pabstaaron/AutoCoffeeMaker/proposal/SeniorProjectProposal/brewStretch.png

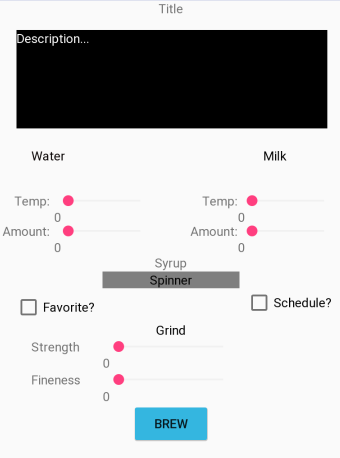
proposal/SeniorProjectProposal/brewStretch.png
