pabstaaron/AutoCoffeeMaker/proposal/SeniorProjectProposal/connect.png

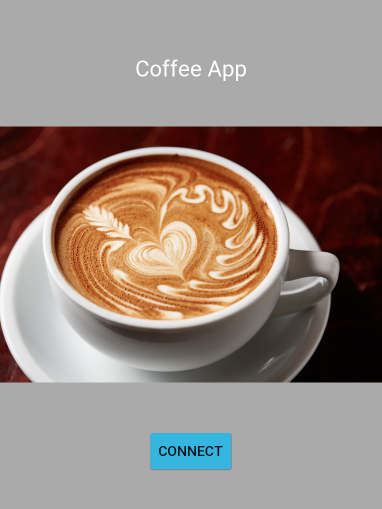
proposal/SeniorProjectProposal/connect.png
