pabstaaron/AutoCoffeeMaker/proposal/SeniorProjectProposal/IMG_20181216_222614.jpg

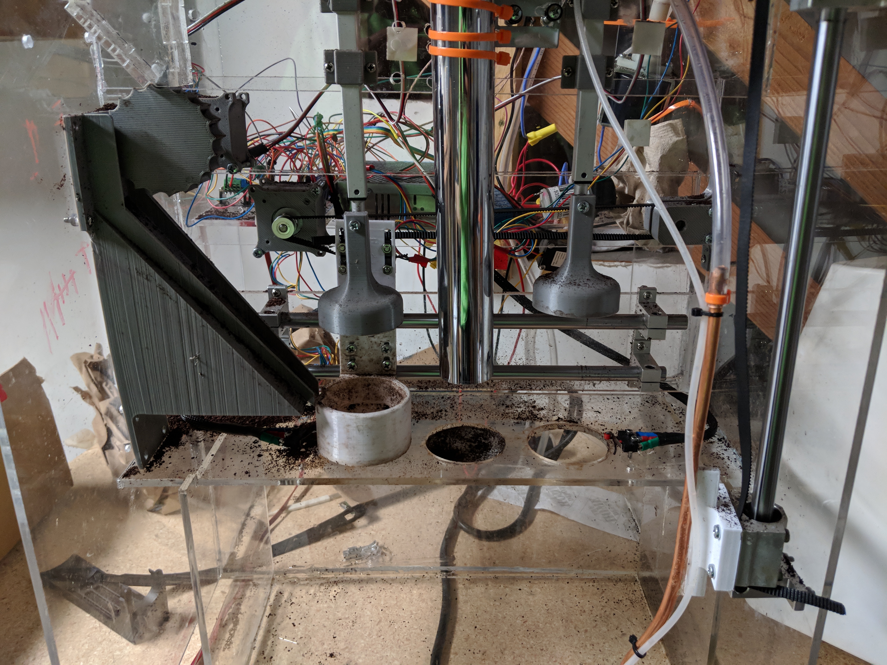
proposal/SeniorProjectProposal/IMG_20181216_222614.jpg
