pabstaaron/AutoCoffeeMaker/proposal/SeniorProjectProposal/Load.png

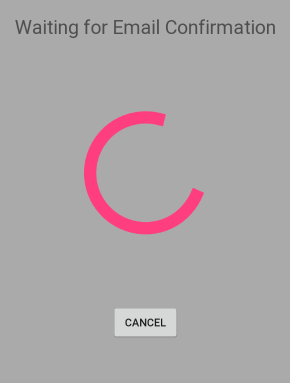
proposal/SeniorProjectProposal/Load.png
