pabstaaron/AutoCoffeeMaker/proposal/SeniorProjectProposal/loginStretch.png

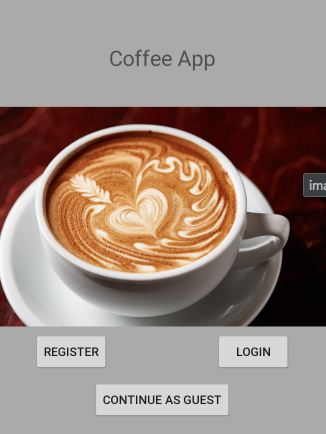
proposal/SeniorProjectProposal/loginStretch.png
