pabstaaron/AutoCoffeeMaker/proposal/SeniorProjectProposal/menu.png

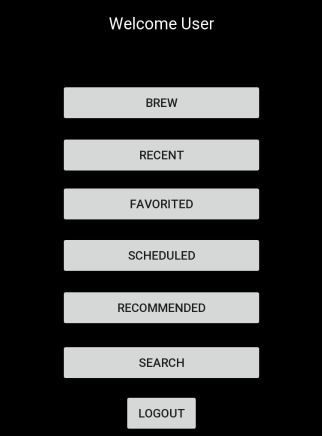
proposal/SeniorProjectProposal/menu.png
