pabstaaron/AutoCoffeeMaker/proposal/SeniorProjectProposal/original pcb layout.png

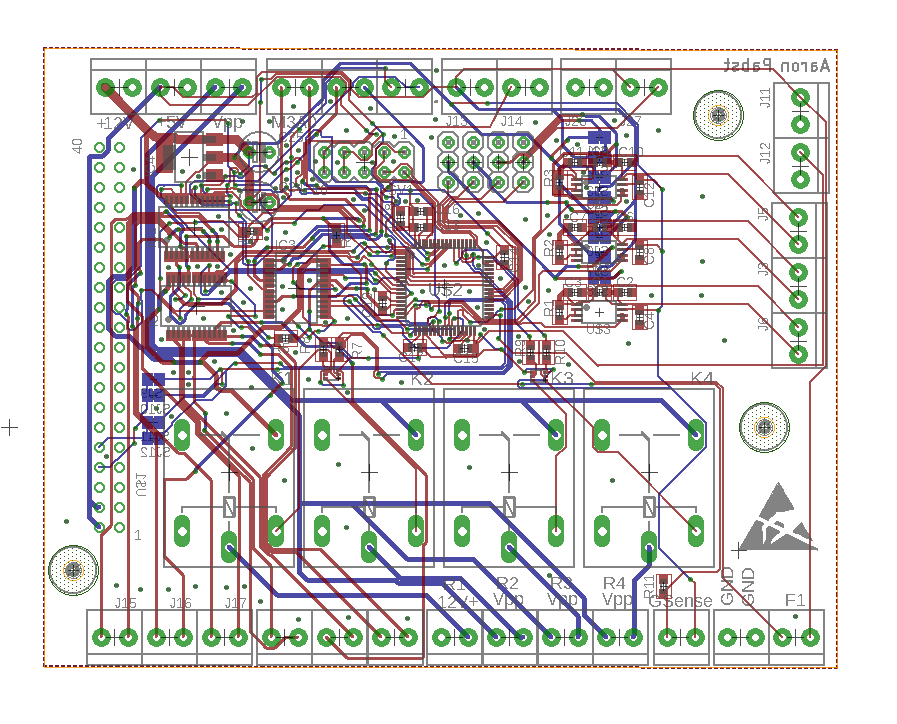
proposal/SeniorProjectProposal/original pcb layout.png
