pabstaaron/AutoCoffeeMaker/proposal/SeniorProjectProposal/original schematic pg 1.png

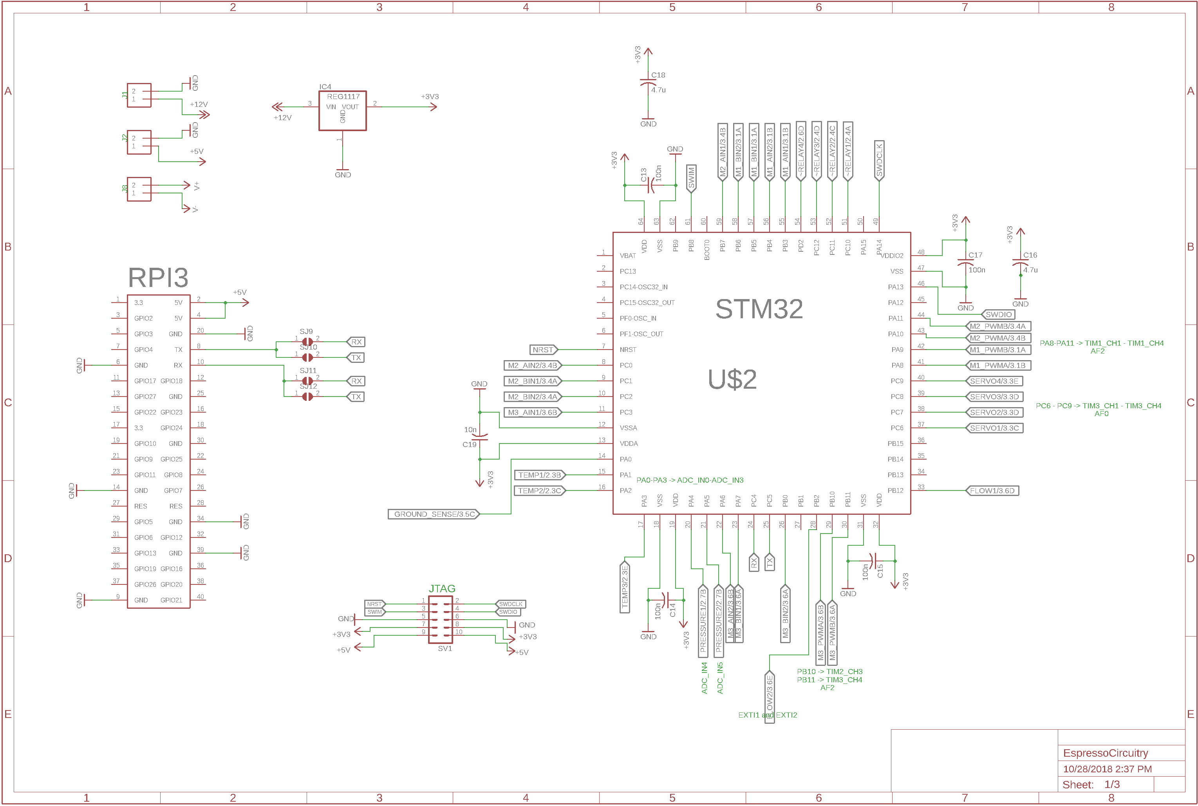
proposal/SeniorProjectProposal/original schematic pg 1.png
