pabstaaron/AutoCoffeeMaker/proposal/SeniorProjectProposal/original schematic pg 2.png

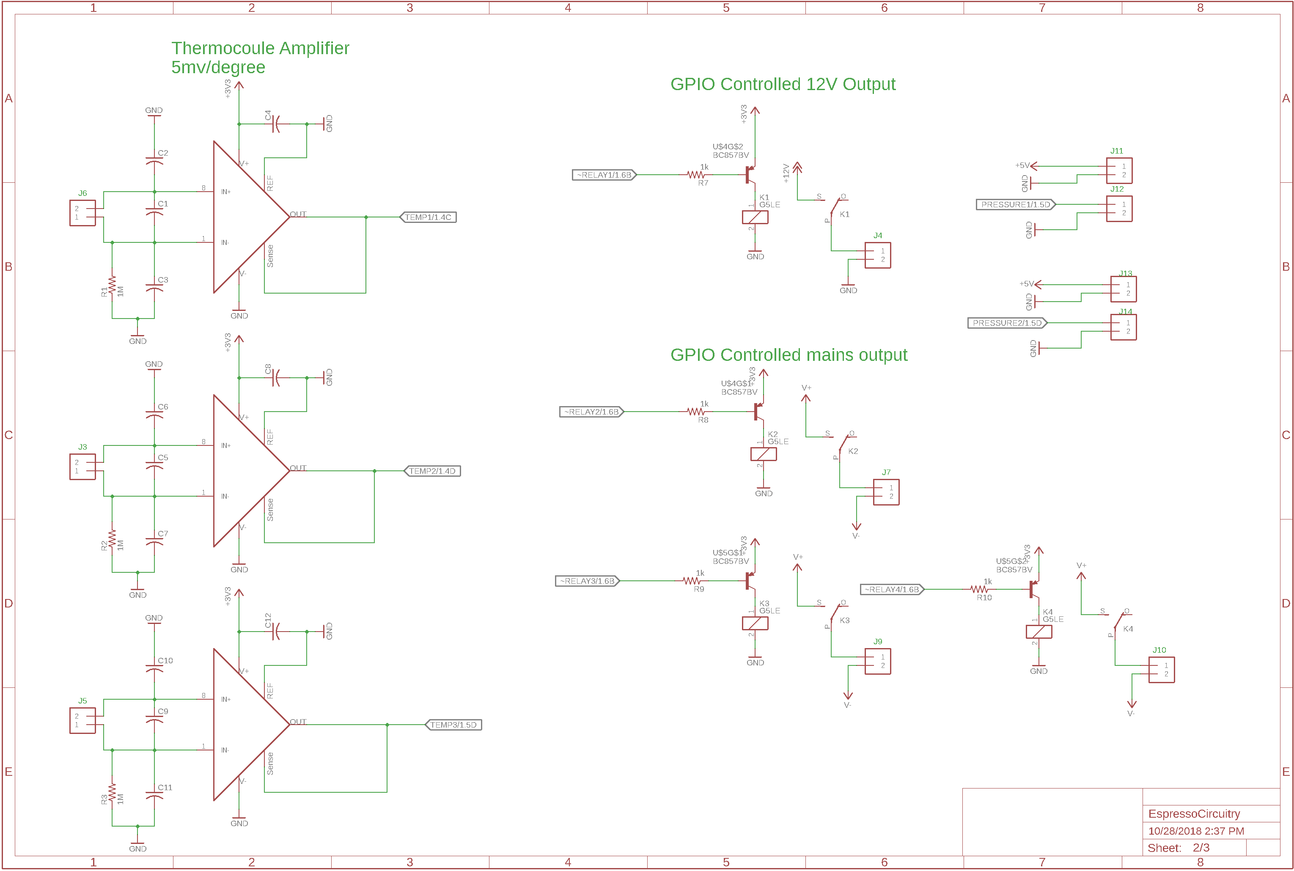
proposal/SeniorProjectProposal/original schematic pg 2.png
