pabstaaron/AutoCoffeeMaker/proposal/SeniorProjectProposal/original schematic pg 3.png

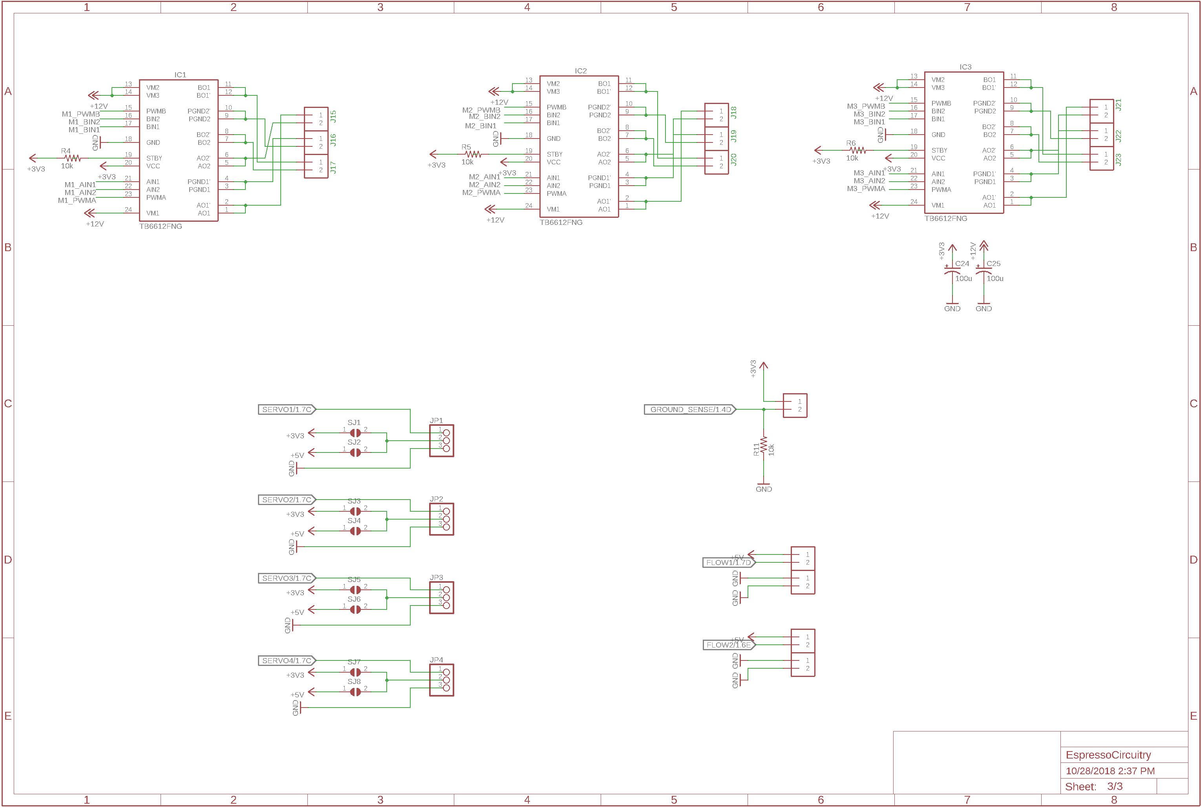
proposal/SeniorProjectProposal/original schematic pg 3.png
