pabstaaron/AutoCoffeeMaker/proposal/SeniorProjectProposal/Register.png

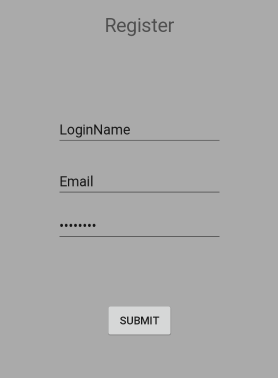
proposal/SeniorProjectProposal/Register.png
