pabstaaron/AutoCoffeeMaker/proposal/SeniorProjectProposal/Schedule.png

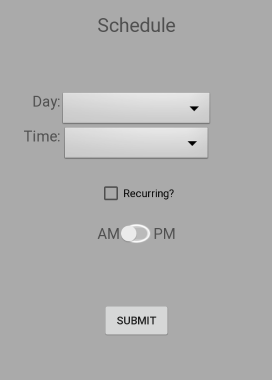
proposal/SeniorProjectProposal/Schedule.png
