pabstaaron/AutoCoffeeMaker/proposal/SeniorProjectProposal/Scheduled.png

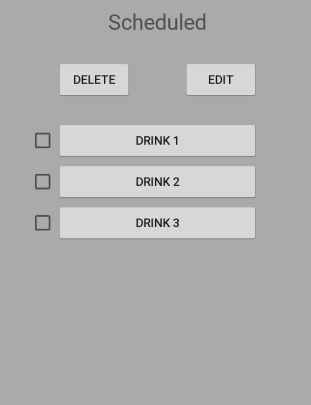
proposal/SeniorProjectProposal/Scheduled.png
