pabstaaron/AutoCoffeeMaker/proposal/SeniorProjectProposal/Search.png

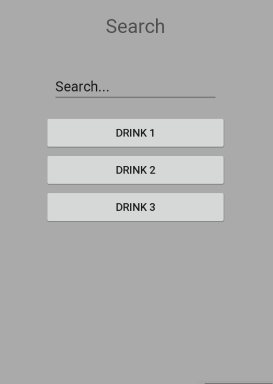
proposal/SeniorProjectProposal/Search.png
