pabstaaron/AutoCoffeeMaker/proposal/SeniorProjectProposal/wifi.png

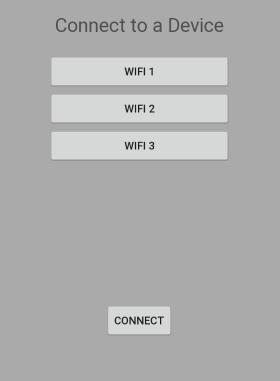
proposal/SeniorProjectProposal/wifi.png
