pabstaaron/AutoCoffeeMaker/EmbeddedCode/gpioTest/MDK-ARM/gpioTest/gpioTest.htm

# Static Call Graph for image gpioTest\gpioTest.axf

#<CALLGRAPH># ARM Linker, 5060750: Last Updated: Tue Oct 30 19:10:04 2018

### Maximum Stack Usage = 188 bytes + Unknown(Cycles, Untraceable Function Pointers)

### Call chain for Maximum Stack Depth:

main ⇒ SystemClock_Config ⇒ HAL_RCC_ClockConfig ⇒ HAL_RCC_GetSysClockFreq ⇒ __aeabi_uidivmod

### Mutually Recursive functions

- ADC1_COMP_IRQHandler ⇒ ADC1_COMP_IRQHandler
- HardFault_Handler ⇒ HardFault_Handler

### Function Pointers

- ADC1_COMP_IRQHandler from startup_stm32f072xb.o(.text) referenced from startup_stm32f072xb.o(RESET)
- CEC_CAN_IRQHandler from startup_stm32f072xb.o(.text) referenced from startup_stm32f072xb.o(RESET)
- DMA1_Channel1_IRQHandler from startup_stm32f072xb.o(.text) referenced from startup_stm32f072xb.o(RESET)
- DMA1_Channel2_3_IRQHandler from startup_stm32f072xb.o(.text) referenced from startup_stm32f072xb.o(RESET)
- DMA1_Channel4_5_6_7_IRQHandler from startup_stm32f072xb.o(.text) referenced from startup_stm32f072xb.o(RESET)
- EXTI0_1_IRQHandler from startup_stm32f072xb.o(.text) referenced from startup_stm32f072xb.o(RESET)
- EXTI2_3_IRQHandler from startup_stm32f072xb.o(.text) referenced from startup_stm32f072xb.o(RESET)
- EXTI4_15_IRQHandler from startup_stm32f072xb.o(.text) referenced from startup_stm32f072xb.o(RESET)
- FLASH_IRQHandler from startup_stm32f072xb.o(.text) referenced from startup_stm32f072xb.o(RESET)
- HardFault_Handler from stm32f0xx_it.o(i.HardFault_Handler) referenced from startup_stm32f072xb.o(RESET)
- I2C1_IRQHandler from startup_stm32f072xb.o(.text) referenced from startup_stm32f072xb.o(RESET)
- I2C2_IRQHandler from startup_stm32f072xb.o(.text) referenced from startup_stm32f072xb.o(RESET)
- NMI_Handler from stm32f0xx_it.o(i.NMI_Handler) referenced from startup_stm32f072xb.o(RESET)
- PVD_VDDIO2_IRQHandler from startup_stm32f072xb.o(.text) referenced from startup_stm32f072xb.o(RESET)
- PendSV_Handler from stm32f0xx_it.o(i.PendSV_Handler) referenced from startup_stm32f072xb.o(RESET)
- RCC_CRS_IRQHandler from startup_stm32f072xb.o(.text) referenced from startup_stm32f072xb.o(RESET)
- RTC_IRQHandler from startup_stm32f072xb.o(.text) referenced from startup_stm32f072xb.o(RESET)
- Reset_Handler from startup_stm32f072xb.o(.text) referenced from startup_stm32f072xb.o(RESET)
- SPI1_IRQHandler from startup_stm32f072xb.o(.text) referenced from startup_stm32f072xb.o(RESET)
- SPI2_IRQHandler from startup_stm32f072xb.o(.text) referenced from startup_stm32f072xb.o(RESET)
- SVC_Handler from stm32f0xx_it.o(i.SVC_Handler) referenced from startup_stm32f072xb.o(RESET)
- SysTick_Handler from stm32f0xx_it.o(i.SysTick_Handler) referenced from startup_stm32f072xb.o(RESET)
- SystemInit from system_stm32f0xx.o(i.SystemInit) referenced from startup_stm32f072xb.o(.text)
- TIM14_IRQHandler from startup_stm32f072xb.o(.text) referenced from startup_stm32f072xb.o(RESET)
- TIM15_IRQHandler from startup_stm32f072xb.o(.text) referenced from startup_stm32f072xb.o(RESET)
- TIM16_IRQHandler from startup_stm32f072xb.o(.text) referenced from startup_stm32f072xb.o(RESET)
- TIM17_IRQHandler from startup_stm32f072xb.o(.text) referenced from startup_stm32f072xb.o(RESET)
- TIM1_BRK_UP_TRG_COM_IRQHandler from startup_stm32f072xb.o(.text) referenced from startup_stm32f072xb.o(RESET)
- TIM1_CC_IRQHandler from startup_stm32f072xb.o(.text) referenced from startup_stm32f072xb.o(RESET)
- TIM2_IRQHandler from startup_stm32f072xb.o(.text) referenced from startup_stm32f072xb.o(RESET)
- TIM3_IRQHandler from startup_stm32f072xb.o(.text) referenced from startup_stm32f072xb.o(RESET)
- TIM6_DAC_IRQHandler from startup_stm32f072xb.o(.text) referenced from startup_stm32f072xb.o(RESET)
- TIM7_IRQHandler from startup_stm32f072xb.o(.text) referenced from startup_stm32f072xb.o(RESET)
- TSC_IRQHandler from startup_stm32f072xb.o(.text) referenced from startup_stm32f072xb.o(RESET)
- USART1_IRQHandler from startup_stm32f072xb.o(.text) referenced from startup_stm32f072xb.o(RESET)
- USART2_IRQHandler from startup_stm32f072xb.o(.text) referenced from startup_stm32f072xb.o(RESET)
- USART3_4_IRQHandler from startup_stm32f072xb.o(.text) referenced from startup_stm32f072xb.o(RESET)
- USB_IRQHandler from startup_stm32f072xb.o(.text) referenced from startup_stm32f072xb.o(RESET)
- WWDG_IRQHandler from startup_stm32f072xb.o(.text) referenced from startup_stm32f072xb.o(RESET)
- __main from entry.o(.ARM.Collect$$$$00000000) referenced from startup_stm32f072xb.o(.text)
- main from main.o(i.main) referenced from entry9a.o(.ARM.Collect$$$$0000000B)

### Global Symbols

__main (Thumb, 0 bytes, Stack size unknown bytes, entry.o(.ARM.Collect$$$$00000000))
[Address Reference Count : 1]

- startup_stm32f072xb.o(.text)

_main_stk (Thumb, 0 bytes, Stack size unknown bytes, entry2.o(.ARM.Collect$$$$00000001))

_main_scatterload (Thumb, 0 bytes, Stack size unknown bytes, entry5.o(.ARM.Collect$$$$00000004))

[Calls]

- >> __scatterload

__main_after_scatterload (Thumb, 0 bytes, Stack size unknown bytes, entry5.o(.ARM.Collect$$$$00000004))

[Called By]

- >> __scatterload

_main_clock (Thumb, 0 bytes, Stack size unknown bytes, entry7b.o(.ARM.Collect$$$$00000008))

_main_cpp_init (Thumb, 0 bytes, Stack size unknown bytes, entry8b.o(.ARM.Collect$$$$0000000A))

_main_init (Thumb, 0 bytes, Stack size unknown bytes, entry9a.o(.ARM.Collect$$$$0000000B))

__rt_final_cpp (Thumb, 0 bytes, Stack size unknown bytes, entry10a.o(.ARM.Collect$$$$0000000D))

__rt_final_exit (Thumb, 0 bytes, Stack size unknown bytes, entry11a.o(.ARM.Collect$$$$0000000F))

Reset_Handler (Thumb, 8 bytes, Stack size 0 bytes, startup_stm32f072xb.o(.text))
[Address Reference Count : 1]

- startup_stm32f072xb.o(RESET)

ADC1_COMP_IRQHandler (Thumb, 0 bytes, Stack size 0 bytes, startup_stm32f072xb.o(.text))

[Calls]

- >> ADC1_COMP_IRQHandler

[Called By]

- >> ADC1_COMP_IRQHandler

[Address Reference Count : 1]

- startup_stm32f072xb.o(RESET)

CEC_CAN_IRQHandler (Thumb, 0 bytes, Stack size 0 bytes, startup_stm32f072xb.o(.text))
[Address Reference Count : 1]

- startup_stm32f072xb.o(RESET)

DMA1_Channel1_IRQHandler (Thumb, 0 bytes, Stack size 0 bytes, startup_stm32f072xb.o(.text))
[Address Reference Count : 1]

- startup_stm32f072xb.o(RESET)

DMA1_Channel2_3_IRQHandler (Thumb, 0 bytes, Stack size 0 bytes, startup_stm32f072xb.o(.text))
[Address Reference Count : 1]

- startup_stm32f072xb.o(RESET)

DMA1_Channel4_5_6_7_IRQHandler (Thumb, 0 bytes, Stack size 0 bytes, startup_stm32f072xb.o(.text))
[Address Reference Count : 1]

- startup_stm32f072xb.o(RESET)

EXTI0_1_IRQHandler (Thumb, 0 bytes, Stack size 0 bytes, startup_stm32f072xb.o(.text))
[Address Reference Count : 1]

- startup_stm32f072xb.o(RESET)

EXTI2_3_IRQHandler (Thumb, 0 bytes, Stack size 0 bytes, startup_stm32f072xb.o(.text))
[Address Reference Count : 1]

- startup_stm32f072xb.o(RESET)

EXTI4_15_IRQHandler (Thumb, 0 bytes, Stack size 0 bytes, startup_stm32f072xb.o(.text))
[Address Reference Count : 1]

- startup_stm32f072xb.o(RESET)

FLASH_IRQHandler (Thumb, 0 bytes, Stack size 0 bytes, startup_stm32f072xb.o(.text))
[Address Reference Count : 1]

- startup_stm32f072xb.o(RESET)

I2C1_IRQHandler (Thumb, 0 bytes, Stack size 0 bytes, startup_stm32f072xb.o(.text))
[Address Reference Count : 1]

- startup_stm32f072xb.o(RESET)

I2C2_IRQHandler (Thumb, 0 bytes, Stack size 0 bytes, startup_stm32f072xb.o(.text))
[Address Reference Count : 1]

- startup_stm32f072xb.o(RESET)

PVD_VDDIO2_IRQHandler (Thumb, 0 bytes, Stack size 0 bytes, startup_stm32f072xb.o(.text))
[Address Reference Count : 1]

- startup_stm32f072xb.o(RESET)

RCC_CRS_IRQHandler (Thumb, 0 bytes, Stack size 0 bytes, startup_stm32f072xb.o(.text))
[Address Reference Count : 1]

- startup_stm32f072xb.o(RESET)

RTC_IRQHandler (Thumb, 0 bytes, Stack size 0 bytes, startup_stm32f072xb.o(.text))
[Address Reference Count : 1]

- startup_stm32f072xb.o(RESET)

SPI1_IRQHandler (Thumb, 0 bytes, Stack size 0 bytes, startup_stm32f072xb.o(.text))
[Address Reference Count : 1]

- startup_stm32f072xb.o(RESET)

SPI2_IRQHandler (Thumb, 0 bytes, Stack size 0 bytes, startup_stm32f072xb.o(.text))
[Address Reference Count : 1]

- startup_stm32f072xb.o(RESET)

TIM14_IRQHandler (Thumb, 0 bytes, Stack size 0 bytes, startup_stm32f072xb.o(.text))
[Address Reference Count : 1]

- startup_stm32f072xb.o(RESET)

TIM15_IRQHandler (Thumb, 0 bytes, Stack size 0 bytes, startup_stm32f072xb.o(.text))
[Address Reference Count : 1]

- startup_stm32f072xb.o(RESET)

TIM16_IRQHandler (Thumb, 0 bytes, Stack size 0 bytes, startup_stm32f072xb.o(.text))
[Address Reference Count : 1]

- startup_stm32f072xb.o(RESET)

TIM17_IRQHandler (Thumb, 0 bytes, Stack size 0 bytes, startup_stm32f072xb.o(.text))
[Address Reference Count : 1]

- startup_stm32f072xb.o(RESET)

TIM1_BRK_UP_TRG_COM_IRQHandler (Thumb, 0 bytes, Stack size 0 bytes, startup_stm32f072xb.o(.text))
[Address Reference Count : 1]

- startup_stm32f072xb.o(RESET)

TIM1_CC_IRQHandler (Thumb, 0 bytes, Stack size 0 bytes, startup_stm32f072xb.o(.text))
[Address Reference Count : 1]

- startup_stm32f072xb.o(RESET)

TIM2_IRQHandler (Thumb, 0 bytes, Stack size 0 bytes, startup_stm32f072xb.o(.text))
[Address Reference Count : 1]

- startup_stm32f072xb.o(RESET)

TIM3_IRQHandler (Thumb, 0 bytes, Stack size 0 bytes, startup_stm32f072xb.o(.text))
[Address Reference Count : 1]

- startup_stm32f072xb.o(RESET)

TIM6_DAC_IRQHandler (Thumb, 0 bytes, Stack size 0 bytes, startup_stm32f072xb.o(.text))
[Address Reference Count : 1]

- startup_stm32f072xb.o(RESET)

TIM7_IRQHandler (Thumb, 0 bytes, Stack size 0 bytes, startup_stm32f072xb.o(.text))
[Address Reference Count : 1]

- startup_stm32f072xb.o(RESET)

TSC_IRQHandler (Thumb, 0 bytes, Stack size 0 bytes, startup_stm32f072xb.o(.text))
[Address Reference Count : 1]

- startup_stm32f072xb.o(RESET)

USART1_IRQHandler (Thumb, 0 bytes, Stack size 0 bytes, startup_stm32f072xb.o(.text))
[Address Reference Count : 1]

- startup_stm32f072xb.o(RESET)

USART2_IRQHandler (Thumb, 0 bytes, Stack size 0 bytes, startup_stm32f072xb.o(.text))
[Address Reference Count : 1]

- startup_stm32f072xb.o(RESET)

USART3_4_IRQHandler (Thumb, 0 bytes, Stack size 0 bytes, startup_stm32f072xb.o(.text))
[Address Reference Count : 1]

- startup_stm32f072xb.o(RESET)

USB_IRQHandler (Thumb, 0 bytes, Stack size 0 bytes, startup_stm32f072xb.o(.text))
[Address Reference Count : 1]

- startup_stm32f072xb.o(RESET)

WWDG_IRQHandler (Thumb, 0 bytes, Stack size 0 bytes, startup_stm32f072xb.o(.text))
[Address Reference Count : 1]

- startup_stm32f072xb.o(RESET)

__aeabi_uidiv (Thumb, 0 bytes, Stack size 12 bytes, uidiv.o(.text), UNUSED)

__aeabi_uidivmod (Thumb, 44 bytes, Stack size 12 bytes, uidiv.o(.text))

[Stack]

- Max Depth = 12
- Call Chain = __aeabi_uidivmod

[Called By]

- >> HAL_InitTick
- >> HAL_RCC_GetSysClockFreq
- >> SystemClock_Config

__scatterload (Thumb, 28 bytes, Stack size 0 bytes, init.o(.text))

[Calls]

- >> __main_after_scatterload

[Called By]

- >> _main_scatterload

__scatterload_rt2 (Thumb, 0 bytes, Stack size 0 bytes, init.o(.text), UNUSED)

HAL_GPIO_Init (Thumb, 314 bytes, Stack size 24 bytes, stm32f0xx_hal_gpio.o(i.HAL_GPIO_Init))

[Stack]

- Max Depth = 24
- Call Chain = HAL_GPIO_Init

[Called By]

- >> main

HAL_GPIO_WritePin (Thumb, 12 bytes, Stack size 0 bytes, stm32f0xx_hal_gpio.o(i.HAL_GPIO_WritePin))

[Called By]

- >> main

HAL_GetTick (Thumb, 6 bytes, Stack size 0 bytes, stm32f0xx_hal.o(i.HAL_GetTick))

[Called By]

- >> HAL_RCC_OscConfig
- >> HAL_RCC_ClockConfig

HAL_IncTick (Thumb, 10 bytes, Stack size 0 bytes, stm32f0xx_hal.o(i.HAL_IncTick))

[Called By]

- >> SysTick_Handler

HAL_Init (Thumb, 26 bytes, Stack size 8 bytes, stm32f0xx_hal.o(i.HAL_Init))

[Stack]

- Max Depth = 28
- Call Chain = HAL_Init ⇒ HAL_InitTick ⇒ __aeabi_uidivmod

[Calls]

- >> HAL_InitTick
- >> HAL_MspInit

[Called By]

- >> main

HAL_InitTick (Thumb, 34 bytes, Stack size 8 bytes, stm32f0xx_hal.o(i.HAL_InitTick))

[Stack]

- Max Depth = 20
- Call Chain = HAL_InitTick ⇒ __aeabi_uidivmod

[Calls]

- >> HAL_SYSTICK_Config
- >> HAL_RCC_GetHCLKFreq
- >> HAL_NVIC_SetPriority
- >> __aeabi_uidivmod

[Called By]

- >> HAL_RCC_ClockConfig
- >> HAL_Init

HAL_MspInit (Thumb, 64 bytes, Stack size 8 bytes, stm32f0xx_hal_msp.o(i.HAL_MspInit))

[Stack]

- Max Depth = 16
- Call Chain = HAL_MspInit ⇒ HAL_NVIC_SetPriority

[Calls]

- >> HAL_NVIC_SetPriority

[Called By]

- >> HAL_Init

HAL_NVIC_SetPriority (Thumb, 8 bytes, Stack size 8 bytes, stm32f0xx_hal_cortex.o(i.HAL_NVIC_SetPriority))

[Stack]

- Max Depth = 8
- Call Chain = HAL_NVIC_SetPriority

[Calls]

- >> NVIC_SetPriority

[Called By]

- >> HAL_InitTick
- >> HAL_MspInit
- >> SystemClock_Config

HAL_RCC_ClockConfig (Thumb, 320 bytes, Stack size 24 bytes, stm32f0xx_hal_rcc.o(i.HAL_RCC_ClockConfig))

[Stack]

- Max Depth = 84
- Call Chain = HAL_RCC_ClockConfig ⇒ HAL_RCC_GetSysClockFreq ⇒ __aeabi_uidivmod

[Calls]

- >> HAL_InitTick
- >> HAL_GetTick
- >> HAL_RCC_GetSysClockFreq

[Called By]

- >> SystemClock_Config

HAL_RCC_GetHCLKFreq (Thumb, 6 bytes, Stack size 0 bytes, stm32f0xx_hal_rcc.o(i.HAL_RCC_GetHCLKFreq))

[Called By]

- >> HAL_InitTick
- >> SystemClock_Config

HAL_RCC_GetSysClockFreq (Thumb, 90 bytes, Stack size 48 bytes, stm32f0xx_hal_rcc.o(i.HAL_RCC_GetSysClockFreq))

[Stack]

- Max Depth = 60
- Call Chain = HAL_RCC_GetSysClockFreq ⇒ __aeabi_uidivmod

[Calls]

- >> __aeabi_uidivmod

[Called By]

- >> HAL_RCC_ClockConfig

HAL_RCC_OscConfig (Thumb, 966 bytes, Stack size 32 bytes, stm32f0xx_hal_rcc.o(i.HAL_RCC_OscConfig))

[Stack]

- Max Depth = 32
- Call Chain = HAL_RCC_OscConfig

[Calls]

- >> HAL_GetTick

[Called By]

- >> SystemClock_Config

HAL_SYSTICK_CLKSourceConfig (Thumb, 20 bytes, Stack size 0 bytes, stm32f0xx_hal_cortex.o(i.HAL_SYSTICK_CLKSourceConfig))

[Called By]

- >> SystemClock_Config

HAL_SYSTICK_Callback (Thumb, 2 bytes, Stack size 0 bytes, stm32f0xx_hal_cortex.o(i.HAL_SYSTICK_Callback))

[Called By]

- >> HAL_SYSTICK_IRQHandler

HAL_SYSTICK_Config (Thumb, 38 bytes, Stack size 8 bytes, stm32f0xx_hal_cortex.o(i.HAL_SYSTICK_Config))

[Stack]

- Max Depth = 8
- Call Chain = HAL_SYSTICK_Config

[Calls]

- >> NVIC_SetPriority

[Called By]

- >> HAL_InitTick
- >> SystemClock_Config

HAL_SYSTICK_IRQHandler (Thumb, 8 bytes, Stack size 8 bytes, stm32f0xx_hal_cortex.o(i.HAL_SYSTICK_IRQHandler))

[Stack]

- Max Depth = 8
- Call Chain = HAL_SYSTICK_IRQHandler

[Calls]

- >> HAL_SYSTICK_Callback

[Called By]

- >> SysTick_Handler

HardFault_Handler (Thumb, 2 bytes, Stack size 0 bytes, stm32f0xx_it.o(i.HardFault_Handler))

[Calls]

- >> HardFault_Handler

[Called By]

- >> HardFault_Handler

[Address Reference Count : 1]

- startup_stm32f072xb.o(RESET)

NMI_Handler (Thumb, 2 bytes, Stack size 0 bytes, stm32f0xx_it.o(i.NMI_Handler))
[Address Reference Count : 1]

- startup_stm32f072xb.o(RESET)

PendSV_Handler (Thumb, 2 bytes, Stack size 0 bytes, stm32f0xx_it.o(i.PendSV_Handler))
[Address Reference Count : 1]

- startup_stm32f072xb.o(RESET)

SVC_Handler (Thumb, 2 bytes, Stack size 0 bytes, stm32f0xx_it.o(i.SVC_Handler))
[Address Reference Count : 1]

- startup_stm32f072xb.o(RESET)

SysTick_Handler (Thumb, 12 bytes, Stack size 8 bytes, stm32f0xx_it.o(i.SysTick_Handler))

[Stack]

- Max Depth = 16
- Call Chain = SysTick_Handler ⇒ HAL_SYSTICK_IRQHandler

[Calls]

- >> HAL_SYSTICK_IRQHandler
- >> HAL_IncTick

[Address Reference Count : 1]

- startup_stm32f072xb.o(RESET)

SystemClock_Config (Thumb, 92 bytes, Stack size 80 bytes, main.o(i.SystemClock_Config))

[Stack]

- Max Depth = 164
- Call Chain = SystemClock_Config ⇒ HAL_RCC_ClockConfig ⇒ HAL_RCC_GetSysClockFreq ⇒ __aeabi_uidivmod

[Calls]

- >> HAL_SYSTICK_Config
- >> HAL_SYSTICK_CLKSourceConfig
- >> HAL_RCC_OscConfig
- >> HAL_RCC_GetHCLKFreq
- >> HAL_RCC_ClockConfig
- >> HAL_NVIC_SetPriority
- >> __aeabi_uidivmod

[Called By]

- >> main

SystemInit (Thumb, 76 bytes, Stack size 0 bytes, system_stm32f0xx.o(i.SystemInit))
[Address Reference Count : 1]

- startup_stm32f072xb.o(.text)

__scatterload_copy (Thumb, 14 bytes, Stack size unknown bytes, handlers.o(i.__scatterload_copy), UNUSED)

__scatterload_null (Thumb, 2 bytes, Stack size unknown bytes, handlers.o(i.__scatterload_null), UNUSED)

__scatterload_zeroinit (Thumb, 14 bytes, Stack size unknown bytes, handlers.o(i.__scatterload_zeroinit), UNUSED)

main (Thumb, 74 bytes, Stack size 24 bytes, main.o(i.main))

[Stack]

- Max Depth = 188
- Call Chain = main ⇒ SystemClock_Config ⇒ HAL_RCC_ClockConfig ⇒ HAL_RCC_GetSysClockFreq ⇒ __aeabi_uidivmod

[Calls]

- >> HAL_Init
- >> HAL_GPIO_WritePin
- >> HAL_GPIO_Init
- >> SystemClock_Config

[Address Reference Count : 1]

- entry9a.o(.ARM.Collect$$$$0000000B)

### Local Symbols

NVIC_SetPriority (Thumb, 60 bytes, Stack size 0 bytes, stm32f0xx_hal_cortex.o(i.NVIC_SetPriority))

[Called By]

- >> HAL_SYSTICK_Config
- >> HAL_NVIC_SetPriority

### Undefined Global Symbols
