pabstaaron/AutoCoffeeMaker/Electronics/EspressoCircuitry/EspressoCircuitry.brd

## EAGLE design Electronics/EspressoCircuitry/EspressoCircuitry.brd (2018-10-07)

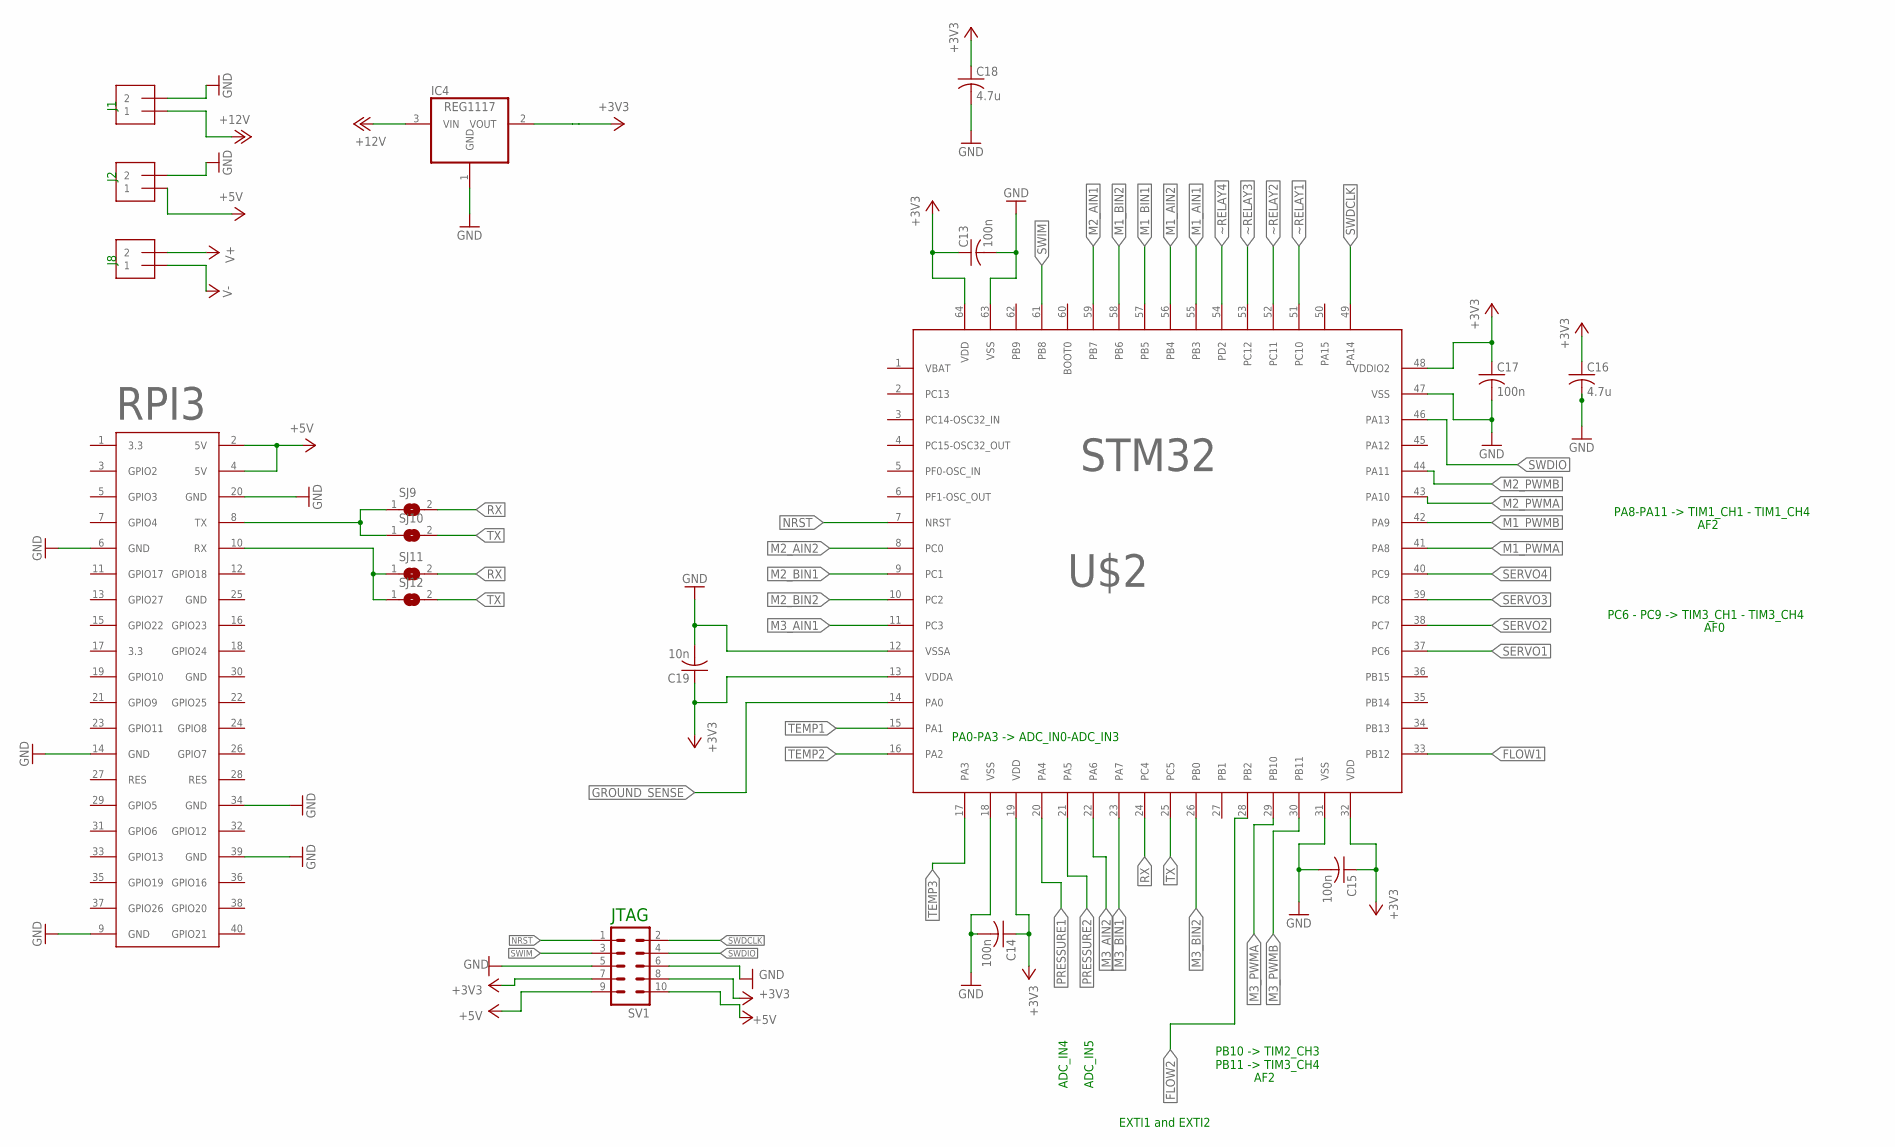
[picture p29: schematic EspressoCircuitry.sch, sheet 1, Power and Embedded Control]

Parts:
C13, C14, C15, C17: 100n; C0603
C16, C18: 4.7u; C0603
C19: 10n; C0603
IC4: REG1117; SOT223
J1, J2, J8: 1X2-3.5MM
SJ9, SJ10, SJ11, SJ12: SJ
SV1: MA05-2
U$1: RPI; FE20-2
U$2: STM32F072RBT6LGFP64; PLQFP64-1

Connections:
+3V3: C13.1, C14.1, C15.1, C16.1, C17.1, C18.1, C19.1, IC4.2 (VOUT), SV1.7, SV1.8, U$2.13 (VDDA), U$2.19 (VDD), U$2.32 (VDD), U$2.48 (VDDIO2), U$2.64 (VDD); also elsewhere on the board
+5V: J2.1, SV1.9, SV1.10, U$1.2 (5V), U$1.4 (5V); also elsewhere on the board
+12V: IC4.3 (VIN), J1.1; also elsewhere on the board
FLOW1: U$2.33 (PB12); also elsewhere on the board
FLOW2: U$2.28 (PB2); also elsewhere on the board
GND: C13.2, C14.2, C15.2, C16.2, C17.2, C18.2, C19.2, IC4.1 (GND), J1.2, J2.2, SV1.5, SV1.6, U$1.6 (GND), U$1.9 (GND), U$1.14 (GND), U$1.20 (GND), U$1.34 (GND), U$1.39 (GND), U$2.12 (VSSA), U$2.18 (VSS), U$2.31 (VSS), U$2.47 (VSS), U$2.63 (VSS); also elsewhere on the board
GROUND_SENSE: U$2.14 (PA0); also elsewhere on the board
M1_AIN1: U$2.55 (PB3); also elsewhere on the board
M1_AIN2: U$2.56 (PB4); also elsewhere on the board
M1_BIN1: U$2.57 (PB5); also elsewhere on the board
M1_BIN2: U$2.58 (PB6); also elsewhere on the board
M1_PWMA: U$2.41 (PA8); also elsewhere on the board
M1_PWMB: U$2.42 (PA9); also elsewhere on the board
M2_AIN1: U$2.59 (PB7); also elsewhere on the board
M2_AIN2: U$2.8 (PC0); also elsewhere on the board
M2_BIN1: U$2.9 (PC1); also elsewhere on the board
M2_BIN2: U$2.10 (PC2); also elsewhere on the board
M2_PWMA: U$2.43 (PA10); also elsewhere on the board
M2_PWMB: U$2.44 (PA11); also elsewhere on the board
M3_AIN1: U$2.11 (PC3); also elsewhere on the board
M3_AIN2: U$2.22 (PA6); also elsewhere on the board
M3_BIN1: U$2.23 (PA7); also elsewhere on the board
M3_BIN2: U$2.26 (PB0); also elsewhere on the board
M3_PWMA: U$2.29 (PB10); also elsewhere on the board
M3_PWMB: U$2.30 (PB11); also elsewhere on the board
unnamed: SJ9.1, SJ10.1, U$1.8 (TX)
unnamed: SJ11.1, SJ12.1, U$1.10 (RX)
NRST: SV1.1, U$2.7 (NRST)
PRESSURE1: U$2.20 (PA4); also elsewhere on the board
PRESSURE2: U$2.21 (PA5); also elsewhere on the board
RX: SJ9.2, SJ11.2, U$2.24 (PC4)
SERVO1: U$2.37 (PC6); also elsewhere on the board
SERVO2: U$2.38 (PC7); also elsewhere on the board
SERVO3: U$2.39 (PC8); also elsewhere on the board
SERVO4: U$2.40 (PC9); also elsewhere on the board
SWDCLK: SV1.2, U$2.49 (PA14)
SWDIO: SV1.4, U$2.46 (PA13)
SWIM: SV1.3, U$2.61 (PB8)
TEMP1: U$2.15 (PA1); also elsewhere on the board
TEMP2: U$2.16 (PA2); also elsewhere on the board
TEMP3: U$2.17 (PA3); also elsewhere on the board
TX: SJ10.2, SJ12.2, U$2.25 (PC5)
V+: J8.2; also elsewhere on the board
V-: J8.1; also elsewhere on the board
~RELAY1: U$2.51 (PC10); also elsewhere on the board
~RELAY2: U$2.52 (PC11); also elsewhere on the board
~RELAY3: U$2.53 (PC12); also elsewhere on the board
~RELAY4: U$2.54 (PD2); also elsewhere on the board

Notes on the sheet:
JTAG
PA8-PA11 -> TIM1_CH1 - TIM1_CH4
PC6 - PC9 -> TIM3_CH1 - TIM3_CH4
PB10 -> TIM2_CH3 PB11 -> TIM3_CH4
AF2
AF0
PA0-PA3 -> ADC_IN0-ADC_IN3
ADC_IN4
ADC_IN5
EXTI1 and EXTI2

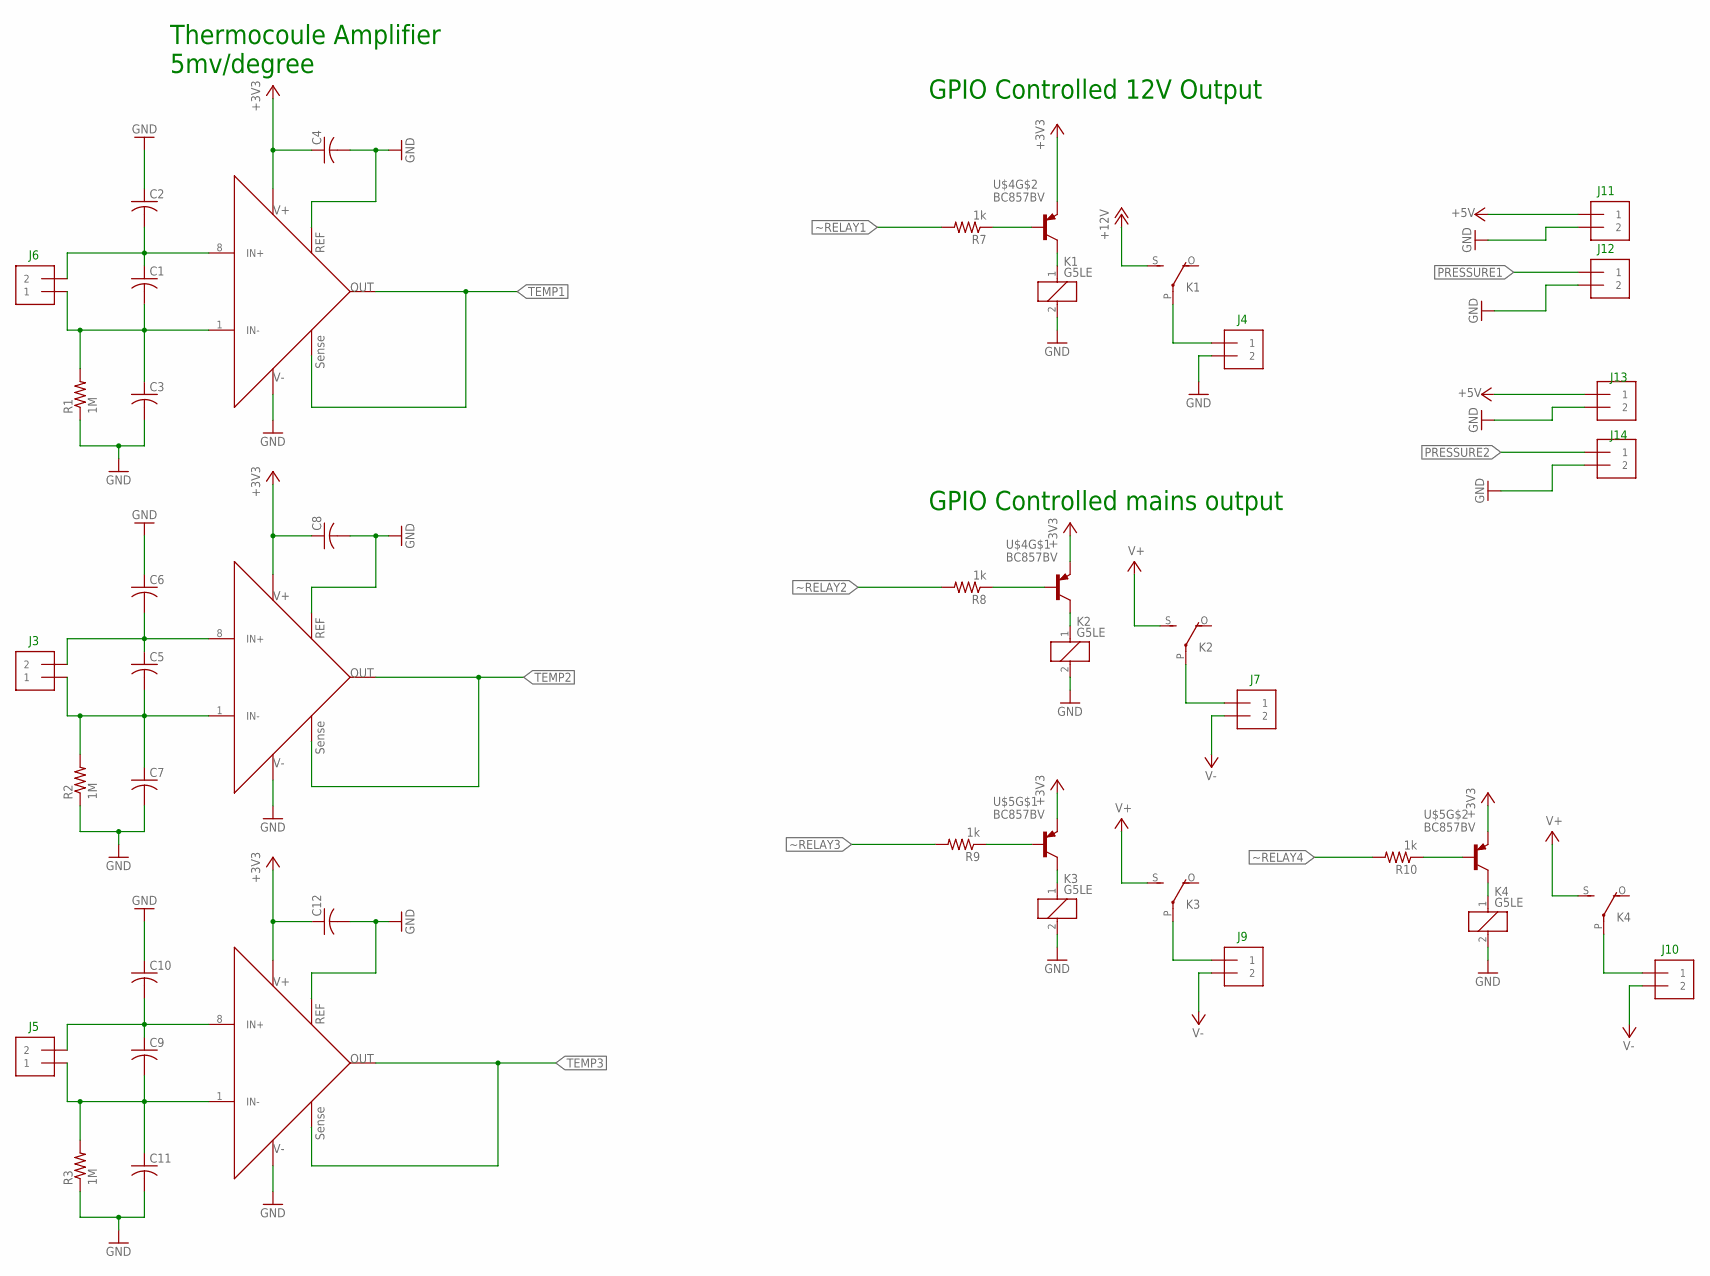
[picture p30: schematic EspressoCircuitry.sch, sheet 2, Thermal Management]

Parts:
C1, C2, C3, C4, C5, C6, C7, C8, C9, C10, C11, C12: C-USC0603; C0603
J3, J4, J5, J6, J7, J9, J10, J11, J12, J13, J14: 1X2-3.5MM
K1, K2, K3, K4: G5LE
R1, R2, R3: 1M; R0603
R7, R8, R9, R10: 1k; R0603
U$3, U$6, U$7: AD8494; TSSOP8
U$4, U$5: BC857BV; SOT-563

Connections:
+3V3: C4.1, C8.1, C12.1, U$3.7 (V+), U$4.P$3 (E), U$4.P$6 (E), U$5.P$3 (E), U$5.P$6 (E), U$6.7 (V+), U$7.7 (V+); also elsewhere on the board
+5V: J11.1, J13.1; also elsewhere on the board
+12V: K1.S; also elsewhere on the board
GND: C2.1, C3.2, C4.2, C6.1, C7.2, C8.2, C10.1, C11.2, C12.2, J4.2, J11.2, J12.2, J13.2, J14.2, K1.2, K2.2, K3.2, K4.2, R1.1, R2.1, R3.1, U$3.2 (REF), U$3.3 (V-), U$6.2 (REF), U$6.3 (V-), U$7.2 (REF), U$7.3 (V-); also elsewhere on the board
unnamed: J4.1, K1.P
unnamed: J7.1, K2.P
unnamed: K1.1, U$4.P$1 (C)
unnamed: K2.1, U$4.P$4 (C)
unnamed: C1.1, C2.2, J6.2, U$3.8 (IN+)
unnamed: C1.2, C3.1, J6.1, R1.2, U$3.1 (IN-)
unnamed: J9.1, K3.P
unnamed: K3.1, U$5.P$4 (C)
unnamed: C5.1, C6.2, J3.2, U$6.8 (IN+)
unnamed: C5.2, C7.1, J3.1, R2.2, U$6.1 (IN-)
unnamed: C9.1, C10.2, J5.2, U$7.8 (IN+)
unnamed: C9.2, C11.1, J5.1, R3.2, U$7.1 (IN-)
unnamed: J10.1, K4.P
unnamed: K4.1, U$5.P$1 (C)
unnamed: R7.1, U$4.P$2 (B)
unnamed: R8.1, U$4.P$5 (B)
unnamed: R9.1, U$5.P$5 (B)
unnamed: R10.1, U$5.P$2 (B)
PRESSURE1: J12.1; also elsewhere on the board
PRESSURE2: J14.1; also elsewhere on the board
TEMP1: U$3.5 (SENSE), U$3.6 (OUT); also elsewhere on the board
TEMP2: U$6.5 (SENSE), U$6.6 (OUT); also elsewhere on the board
TEMP3: U$7.5 (SENSE), U$7.6 (OUT); also elsewhere on the board
V+: K2.S, K3.S, K4.S; also elsewhere on the board
V-: J7.2, J9.2, J10.2; also elsewhere on the board
~RELAY1: R7.2; also elsewhere on the board
~RELAY2: R8.2; also elsewhere on the board
~RELAY3: R9.2; also elsewhere on the board
~RELAY4: R10.2; also elsewhere on the board

Notes on the sheet:
GPIO Controlled 12V Output
Thermocoule Amplifier 5mv/degree
GPIO Controlled mains output
J10
J11
J12
J13
J14

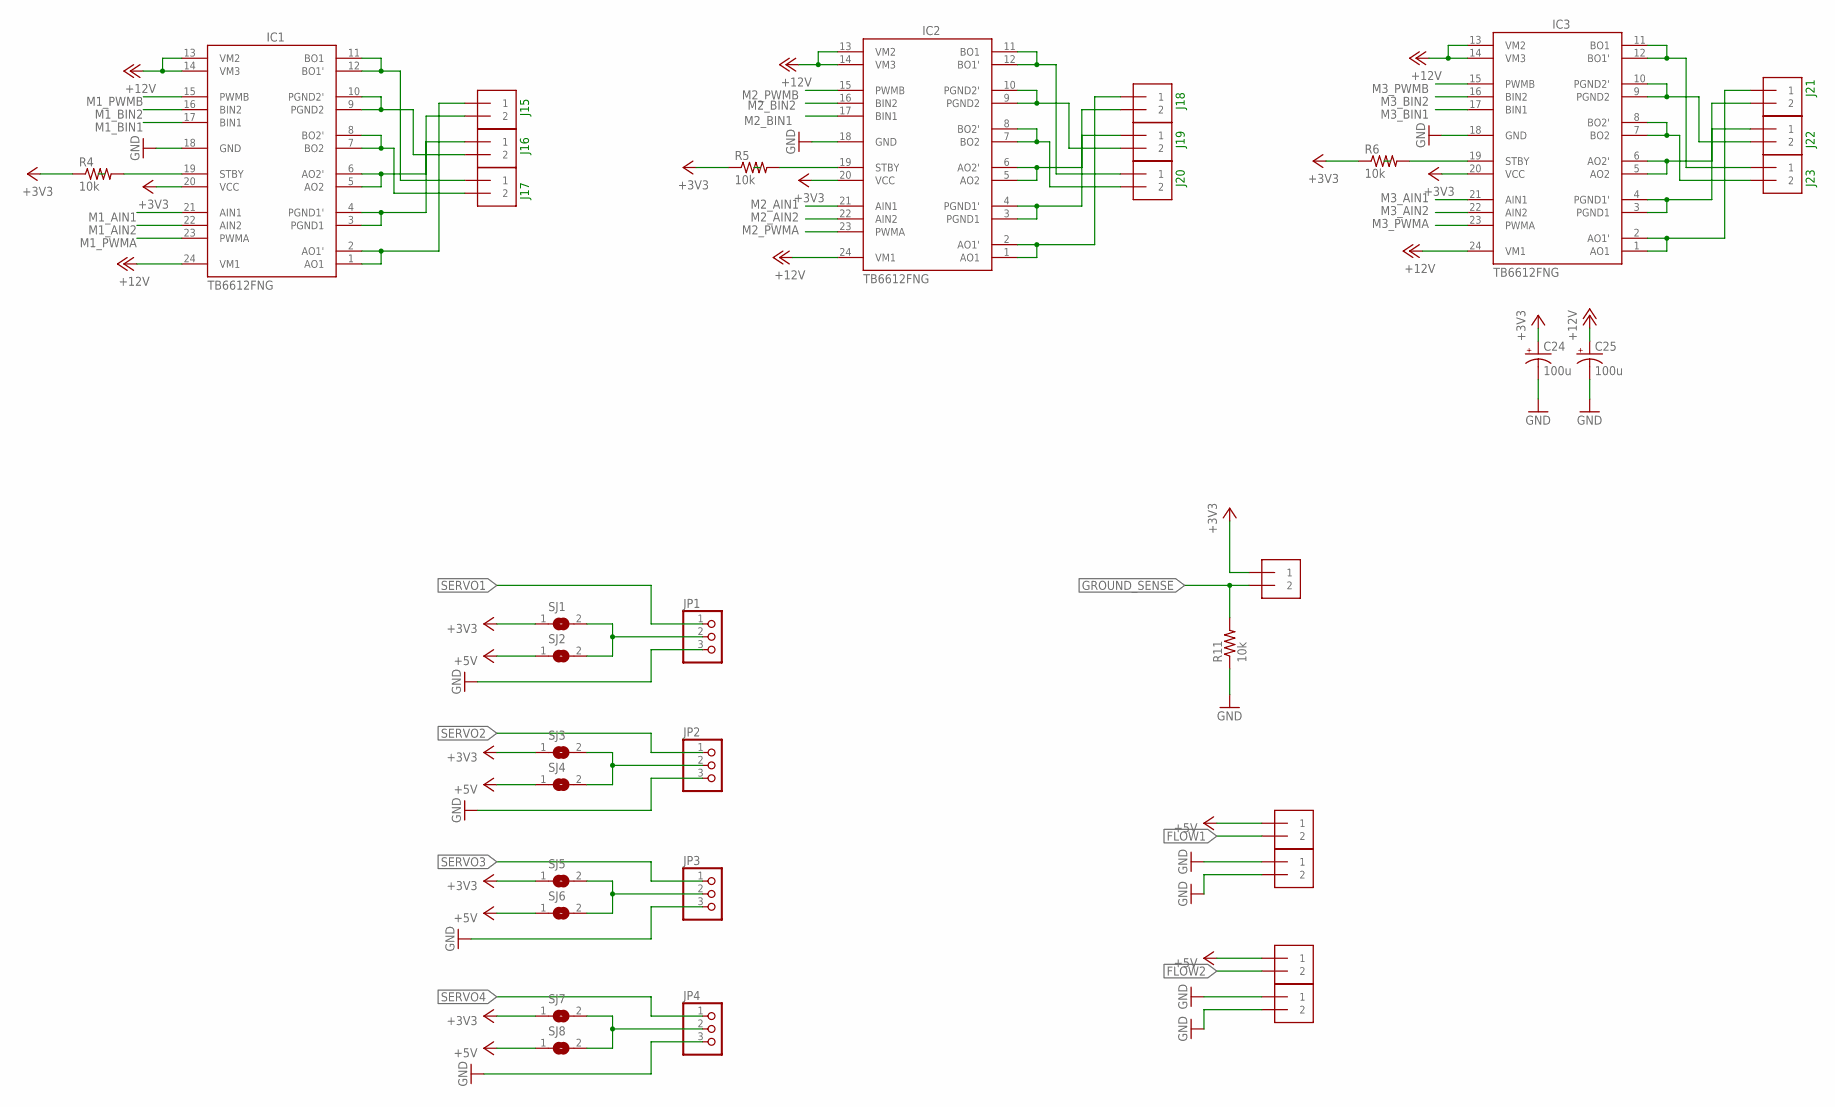
[picture p31: schematic EspressoCircuitry.sch, sheet 3, Mechanical Control]

Parts:
C24, C25: 100u; E2,5-5
IC1, IC2, IC3: TB6612FNG; SSOP24
J15, J16, J17, J18, J19, J20, J21, J22, J23, J24, J25, J26, J27, J28: 1X2-3.5MM
JP1, JP2, JP3, JP4: PINHD-1X3; 1X03
R4, R5, R6, R11: 10k; R0603
SJ1, SJ2, SJ3, SJ4, SJ5, SJ6, SJ7, SJ8: SJ

Connections:
+3V3: C24.+, IC1.20 (VCC), IC2.20 (VCC), IC3.20 (VCC), J24.1, R4.1, R5.1, R6.1, SJ1.1, SJ3.1, SJ5.1, SJ7.1; also elsewhere on the board
+5V: J25.1, J27.1, SJ2.1, SJ4.1, SJ6.1, SJ8.1; also elsewhere on the board
+12V: C25.+, IC1.13 (VM2), IC1.14 (VM3), IC1.24 (VM1), IC2.13 (VM2), IC2.14 (VM3), IC2.24 (VM1), IC3.13 (VM2), IC3.14 (VM3), IC3.24 (VM1); also elsewhere on the board
FLOW1: J25.2; also elsewhere on the board
FLOW2: J27.2; also elsewhere on the board
GND: C24.-, C25.-, IC1.18 (GND), IC2.18 (GND), IC3.18 (GND), J26.1, J26.2, J28.1, J28.2, JP1.3, JP2.3, JP3.3, JP4.3, R11.1; also elsewhere on the board
GROUND_SENSE: J24.2, R11.2; also elsewhere on the board
M1_AIN1: IC1.21 (AIN1); also elsewhere on the board
M1_AIN2: IC1.22 (AIN2); also elsewhere on the board
M1_BIN1: IC1.17 (BIN1); also elsewhere on the board
M1_BIN2: IC1.16 (BIN2); also elsewhere on the board
M1_PWMA: IC1.23 (PWMA); also elsewhere on the board
M1_PWMB: IC1.15 (PWMB); also elsewhere on the board
M2_AIN1: IC2.21 (AIN1); also elsewhere on the board
M2_AIN2: IC2.22 (AIN2); also elsewhere on the board
M2_BIN1: IC2.17 (BIN1); also elsewhere on the board
M2_BIN2: IC2.16 (BIN2); also elsewhere on the board
M2_PWMA: IC2.23 (PWMA); also elsewhere on the board
M2_PWMB: IC2.15 (PWMB); also elsewhere on the board
M3_AIN1: IC3.21 (AIN1); also elsewhere on the board
M3_AIN2: IC3.22 (AIN2); also elsewhere on the board
M3_BIN1: IC3.17 (BIN1); also elsewhere on the board
M3_BIN2: IC3.16 (BIN2); also elsewhere on the board
M3_PWMA: IC3.23 (PWMA); also elsewhere on the board
M3_PWMB: IC3.15 (PWMB); also elsewhere on the board
unnamed: IC1.1 (AO1), IC1.2 (AO1'), J15.1
unnamed: IC1.3 (PGND1), IC1.4 (PGND1'), J16.1
unnamed: IC1.5 (AO2), IC1.6 (AO2'), J15.2
unnamed: IC1.7 (BO2), IC1.8 (BO2'), J17.2
unnamed: IC1.9 (PGND2), IC1.10 (PGND2'), J16.2
unnamed: IC1.11 (BO1), IC1.12 (BO1'), J17.1
unnamed: IC1.19 (STBY), R4.2
unnamed: IC2.1 (AO1), IC2.2 (AO1'), J18.1
unnamed: IC2.3 (PGND1), IC2.4 (PGND1'), J19.1
unnamed: IC2.5 (AO2), IC2.6 (AO2'), J18.2
unnamed: IC2.7 (BO2), IC2.8 (BO2'), J20.2
unnamed: IC2.9 (PGND2), IC2.10 (PGND2'), J19.2
unnamed: IC2.11 (BO1), IC2.12 (BO1'), J20.1
unnamed: IC2.19 (STBY), R5.2
unnamed: IC3.1 (AO1), IC3.2 (AO1'), J21.1
unnamed: IC3.3 (PGND1), IC3.4 (PGND1'), J22.1
unnamed: IC3.5 (AO2), IC3.6 (AO2'), J21.2
unnamed: IC3.7 (BO2), IC3.8 (BO2'), J23.2
unnamed: IC3.9 (PGND2), IC3.10 (PGND2'), J22.2
unnamed: IC3.11 (BO1), IC3.12 (BO1'), J23.1
unnamed: IC3.19 (STBY), R6.2
unnamed: JP1.2, SJ1.2, SJ2.2
unnamed: JP2.2, SJ3.2, SJ4.2
unnamed: JP3.2, SJ5.2, SJ6.2
unnamed: JP4.2, SJ7.2, SJ8.2
SERVO1: JP1.1; also elsewhere on the board
SERVO2: JP2.1; also elsewhere on the board
SERVO3: JP3.1; also elsewhere on the board
SERVO4: JP4.1; also elsewhere on the board

Notes on the sheet:
J15
J16
J17
J18
J19
J20
J21
J22
J23

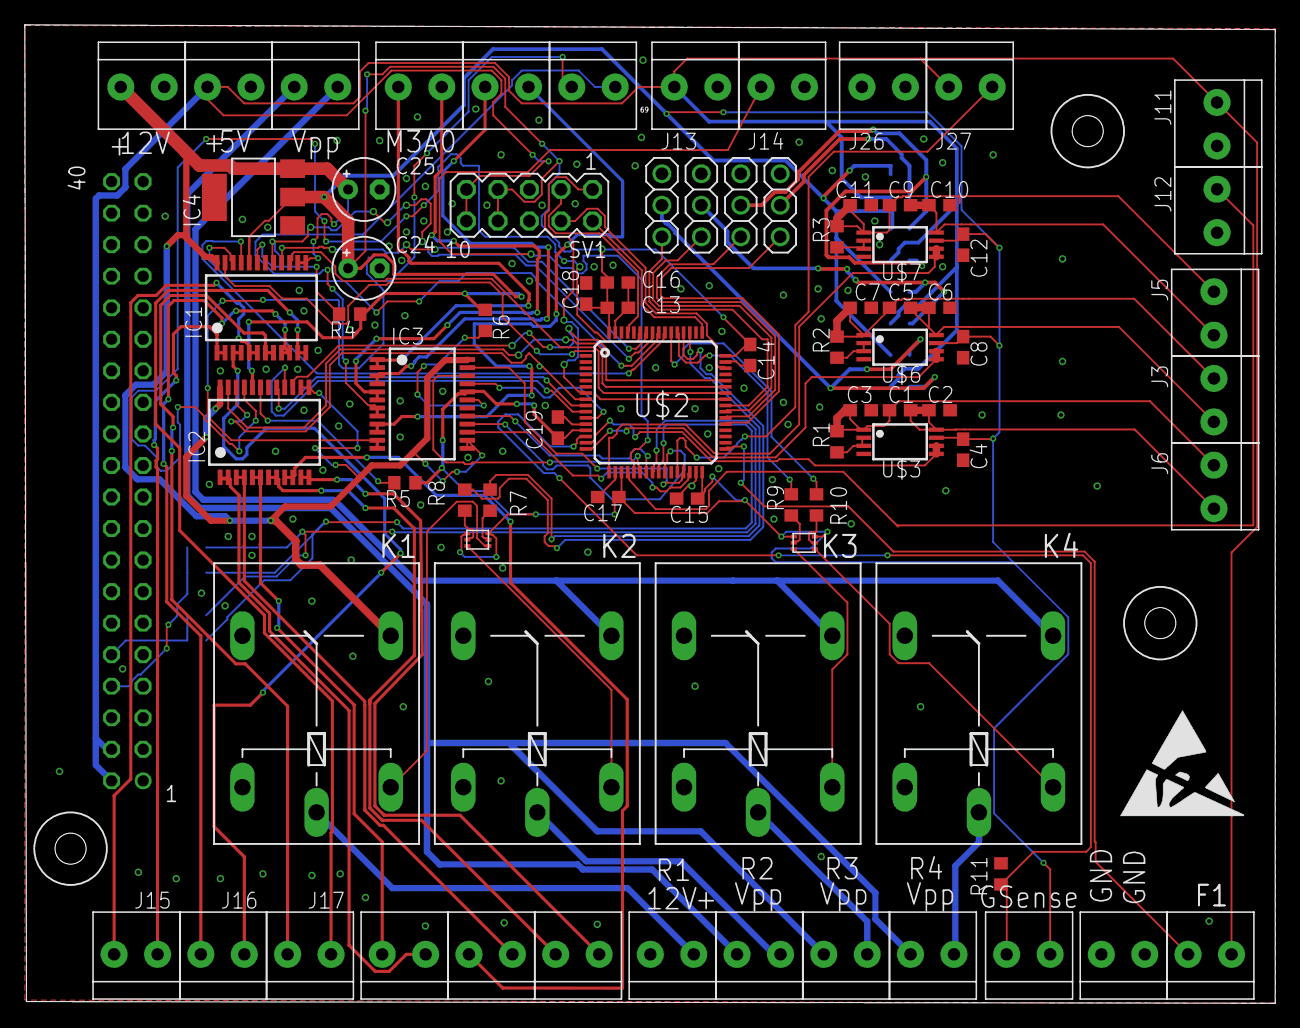
[picture p32: board EspressoCircuitry.brd from above]

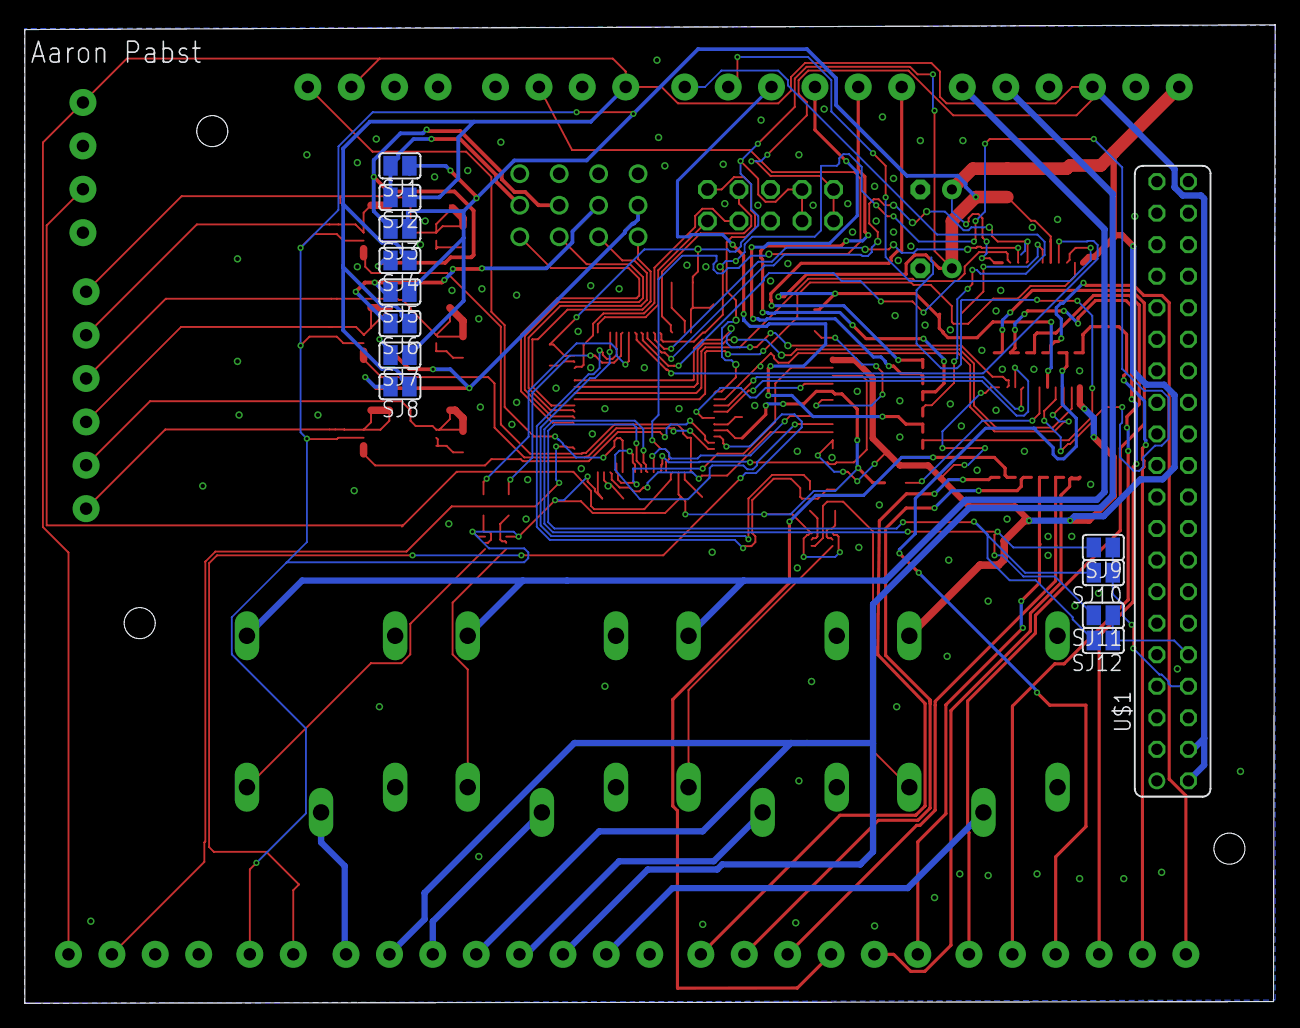
[picture p33: board EspressoCircuitry.brd from below]

Board: 2 copper layers, 100.7 x 78.8 mm, 96 parts (12 on the bottom side), 91 nets.

Other parts of the board:
U$8: ESD_10.00
U$9, U$10, U$11: DRIL-2,5
