pabstaaron/AutoCoffeeMaker/EmbeddedCode/main.c

/**
  ******************************************************************************
  * @file           : main.c
  * @brief          : Main program body
  ******************************************************************************
  ** This notice applies to any and all portions of this file
  * that are not between comment pairs USER CODE BEGIN and
  * USER CODE END. Other portions of this file, whether 
  * inserted by the user or by software development tools
  * are owned by their respective copyright owners.
  *
  * COPYRIGHT(c) 2018 STMicroelectronics
  *
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
  ******************************************************************************
  */
/* Includes ------------------------------------------------------------------*/
#include "main.h"
#include "stm32f0xx_hal.h"

/* USER CODE BEGIN Includes */
#include "UART.h"
#include "Pump.h"
#include "Heater.h"
/* USER CODE END Includes */

ADC_HandleTypeDef hadc;

TIM_HandleTypeDef htim3;
TIM_HandleTypeDef htim14;

/* USER CODE BEGIN PV */

/* USER CODE END PV */

void SystemClock_Config(void);
static void MX_GPIO_Init(void);
static void MX_TIM3_Init(void);
static void MX_ADC_Init(void);
static void MX_TIM14_Init(void);

void HAL_TIM_MspPostInit(TIM_HandleTypeDef *htim);
                                

/* USER CODE BEGIN PFP */

/* USER CODE END PFP */

/**
  * @brief  The application entry point.
  *
  * @retval None
  */
int main(void)
{
  /* MCU Configuration----------------------------------------------------------*/

  /* Reset of all peripherals, Initializes the Flash interface and the Systick. */
  HAL_Init();

  /* Configure the system clock */
  SystemClock_Config();

  /* Initialize all configured peripherals */
  MX_GPIO_Init();
  MX_TIM3_Init();
  MX_ADC_Init();
  MX_TIM14_Init();
  /* USER CODE BEGIN 2 */
	UART_Init();
	pumpInit();
	heater_init();
	HAL_TIM_Base_Start_IT(&htim3); // Start timer 3
	HAL_GPIO_WritePin(GPIOA, GPIO_PIN_5, GPIO_PIN_SET);
	sendString("Init\n\r");
  /* USER CODE END 2 */

  /* Infinite loop */
  /* USER CODE BEGIN WHILE */
  while (1)
  {
//		HAL_GPIO_TogglePin(GPIOA, GPIO_PIN_5); // Flip relay
//		sendString("Flip\n\r");
//		HAL_Delay(2000);
  /* USER CODE END WHILE */

  /* USER CODE BEGIN 3 */

  }
  /* USER CODE END 3 */

}

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
