pabstaaron/AutoCoffeeMaker/final project code/Inc/leds.h

#ifndef leds_H_
#define leds_H_

void LEDS_Init(void);
void red_on(void);
void red_off(void);
void orange_on(void);
void orange_off(void);
void blue_on(void);
void blue_off(void);
void green_on(void);
void green_off(void);
void clear(void);

#endif 
