pabstaaron/AutoCoffeeMaker/Arduino Code/new_coffee_code/Relays.ino

/**
 * Sets relay1 to `enable`
 */
void setRelay1(bool enable) {
  if(enable)
    digitalWrite(RELAY_SWITCH1, LOW);
  else
    digitalWrite(RELAY_SWITCH1, HIGH);  
}

/**
 * Sets relay2 to `enable`
 */
void setRelay2(bool enable) {
  if(enable)
    digitalWrite(RELAY_SWITCH2, LOW);
  else
    digitalWrite(RELAY_SWITCH2, HIGH);  
}

/**
 * Sets relay3 to `enable`
 */
void setRelay3(bool enable) {
  if(enable)
    digitalWrite(RELAY_SWITCH3, LOW);
  else
    digitalWrite(RELAY_SWITCH3, HIGH);  
}

/**
 * Sets relay4 to `enable`
 */
void setRelay4(bool enable) {
  if(enable)
    digitalWrite(RELAY_SWITCH4, LOW);
  else
    digitalWrite(RELAY_SWITCH4, HIGH);  
}

/**
 * Turns the boiler on/off
 */
void setBoiler(bool enable){
  setRelay1(enable);
  setRelay2(enable);
}

/**
 * Turns the brewing pump on/off
 */
void setPump(bool enable){
  setRelay3(enable);
  setRelay4(enable);
}

/**
 * Sets all relays in the system to off
 */
void resetAllRelays() {
  setRelay1(false);
  setRelay2(false);
  setRelay3(false);
  setRelay4(false);
}
