pabstaaron/AutoCoffeeMaker/EmbeddedCode/gpioTest/gpioTest.ioc

Mcu.UserName=STM32F072RBTx
PC6.Signal=GPIO_Output
