pabstaaron/AutoCoffeeMaker/(commit log)

2018-03-07 Updated index.html log Document.tex added flask overview, list for project tasks, list for materials
2018-03-07 SeniorProjectProposal: Added mobile UI sections to Overview, Tasks, Materials, Testing, and Demonstration
2018-05-08 Beanster: Added ThreadManager and WifiRunner Thread. Next I will be adding file writing priveleges and the logic to connect to raspBerry PI
2018-05-18 Finished wifiRunner, going to make UI for connecting device and then test it with RaspberryPI
2018-05-19 flask/stm32.py - added base serial implmenetation of serial communication to stm32 board
2018-05-19 Working on UI and communication for device connection
2018-05-24 Finished recycler view, now finishing up device selection screen and then will test with PI, afterward we can start working on functions of device and mobile app and PI
2018-06-10 Added embedded UART code for STM chips
2018-06-25 Added symbols and footprints for the RPI 3, STM32 chip, AD8494, etc...
2018-07-04 Trying to debug sending json to device
2018-07-23 Completed PCB schematic and initial component placement
    [EspressoCircuitry.brd, EspressoCircuitry.sch]
2018-09-30 Added updated PCB files
    [EspressoCircuitry.brd, EspressoCircuitry.sch]
2018-10-03 Added login support for first page, as well as structure for user data, will probably do same for device data so i don't have to use files
2018-10-07 added final project files - Pretty complete UART code - LED Drivers for STM32F0 discovery board
2018-10-14 flask_server: Added python code to communicate with STM board - Added pwm code to test functionality Final Project Code - Adjusted UART such that it will consistently work across command states
2018-10-20 feature/added-stepper-port-code Added some general stepper motor logic.
    This is displayed on the STM32F0 board using the LEDS for the bipolar
    logic.
    Two methods were added:
    rotate(steps, speed)
    rotate_degrees(deg, speed)
    This needs testing and modification using the real stepper motor.
2018-10-30 Updated code for stepper
2018-10-30 Ported arduino stepper code
2018-11-03 stepper-motor arduino code Added arduino code for Arduino Feather M0
2018-11-07 Added code to control the linear actuator
2018-11-07 Added actuator control code
2018-11-08 Added code for multiple servos and multiple steppers.
    First Demo Code for 11/8/2018
2018-11-11 Added startup code, cleaned up code by partitioning serial logic away from main loop.
    Cleaned up unused code,
    Sped up calibration by setting dispense position ~575 steps away
    (without belt slipping 600 is probably extremely close to the actual
    position)
    Problems found:
    - Brew motor needs to be blocking run
    - dispense command does not always fire. needs to be blocking as
    well
    - calibration values might be wrong in some pars
    [stepper_code.ino]
2018-11-13 Seperated logic into individual classes. Added logic for Relays
2018-11-16 changed stepper code to minimum of 1050. Added demo code to arduino
2018-11-16 changed stm->serialUART.
    Added commands to send to arduino.
    Involved modifying old parsing mechanism for the simple `readline()`
    Added DEMO command.
2018-12-05 Hopefully final, fixed things with multiple devices
