pabstaaron/AutoCoffeeMaker/(notices)

Notices in the files:
EmbeddedCode/main.c:
(C) COPYRIGHT STMicroelectronics *****END OF FILE
